InfiniteCod3/pico-pwm-generator/docs/mereni/seriova_linka_2026-10-13.txt

  3601 ms  Freq:    1000 Hz  Duty: 50 %  ON   (skutecne 1000.00 Hz)
  6678 ms  Freq:    1100 Hz  Duty: 50 %  ON   (skutecne 1100.00 Hz)
  7118 ms  Freq:    1200 Hz  Duty: 50 %  ON   (skutecne 1199.99 Hz)
  7632 ms  Freq:    1300 Hz  Duty: 50 %  ON   (skutecne 1299.99 Hz)
  8006 ms  Freq:    1400 Hz  Duty: 50 %  ON   (skutecne 1400.00 Hz)
  8068 ms  Freq:    1500 Hz  Duty: 50 %  ON   (skutecne 1500.00 Hz)
  8100 ms  Freq:    1600 Hz  Duty: 50 %  ON   (skutecne 1600.00 Hz)
  8131 ms  Freq:    1700 Hz  Duty: 50 %  ON   (skutecne 1700.01 Hz)
  8191 ms  Freq:    1800 Hz  Duty: 50 %  ON   (skutecne 1800.01 Hz)
  8223 ms  Freq:    1900 Hz  Duty: 50 %  ON   (skutecne 1899.98 Hz)
  8285 ms  Freq:    2000 Hz  Duty: 50 %  ON   (skutecne 2000.00 Hz)
  8317 ms  Freq:    2100 Hz  Duty: 50 %  ON   (skutecne 2099.99 Hz)
  8973 ms  Freq:    2200 Hz  Duty: 50 %  ON   (skutecne 2200.01 Hz)
  9379 ms  Freq:    2300 Hz  Duty: 50 %  ON   (skutecne 2299.99 Hz)
  9440 ms  Freq:    2400 Hz  Duty: 50 %  ON   (skutecne 2400.02 Hz)
  9471 ms  Freq:    2500 Hz  Duty: 50 %  ON   (skutecne 2500.00 Hz)
  9502 ms  Freq:    2600 Hz  Duty: 50 %  ON   (skutecne 2600.00 Hz)
  9564 ms  Freq:    2700 Hz  Duty: 50 %  ON   (skutecne 2700.02 Hz)
  9595 ms  Freq:    2800 Hz  Duty: 50 %  ON   (skutecne 2799.99 Hz)
  9626 ms  Freq:    2900 Hz  Duty: 50 %  ON   (skutecne 2900.03 Hz)
  9656 ms  Freq:    3000 Hz  Duty: 50 %  ON   (skutecne 2999.98 Hz)
  9719 ms  Freq:    3100 Hz  Duty: 50 %  ON   (skutecne 3099.97 Hz)
  9750 ms  Freq:    3200 Hz  Duty: 50 %  ON   (skutecne 3199.96 Hz)
  9781 ms  Freq:    3300 Hz  Duty: 50 %  ON   (skutecne 3299.98 Hz)
  9844 ms  Freq:    3400 Hz  Duty: 50 %  ON   (skutecne 3399.97 Hz)
  9876 ms  Freq:    3500 Hz  Duty: 50 %  ON   (skutecne 3500.03 Hz)
  9907 ms  Freq:    3600 Hz  Duty: 50 %  ON   (skutecne 3600.02 Hz)
  9969 ms  Freq:    3700 Hz  Duty: 50 %  ON   (skutecne 3699.98 Hz)
 10000 ms  Freq:    3800 Hz  Duty: 50 %  ON   (skutecne 3799.97 Hz)
