InfiniteCod3/pico-pwm-generator/docs/schema/generator.pdf

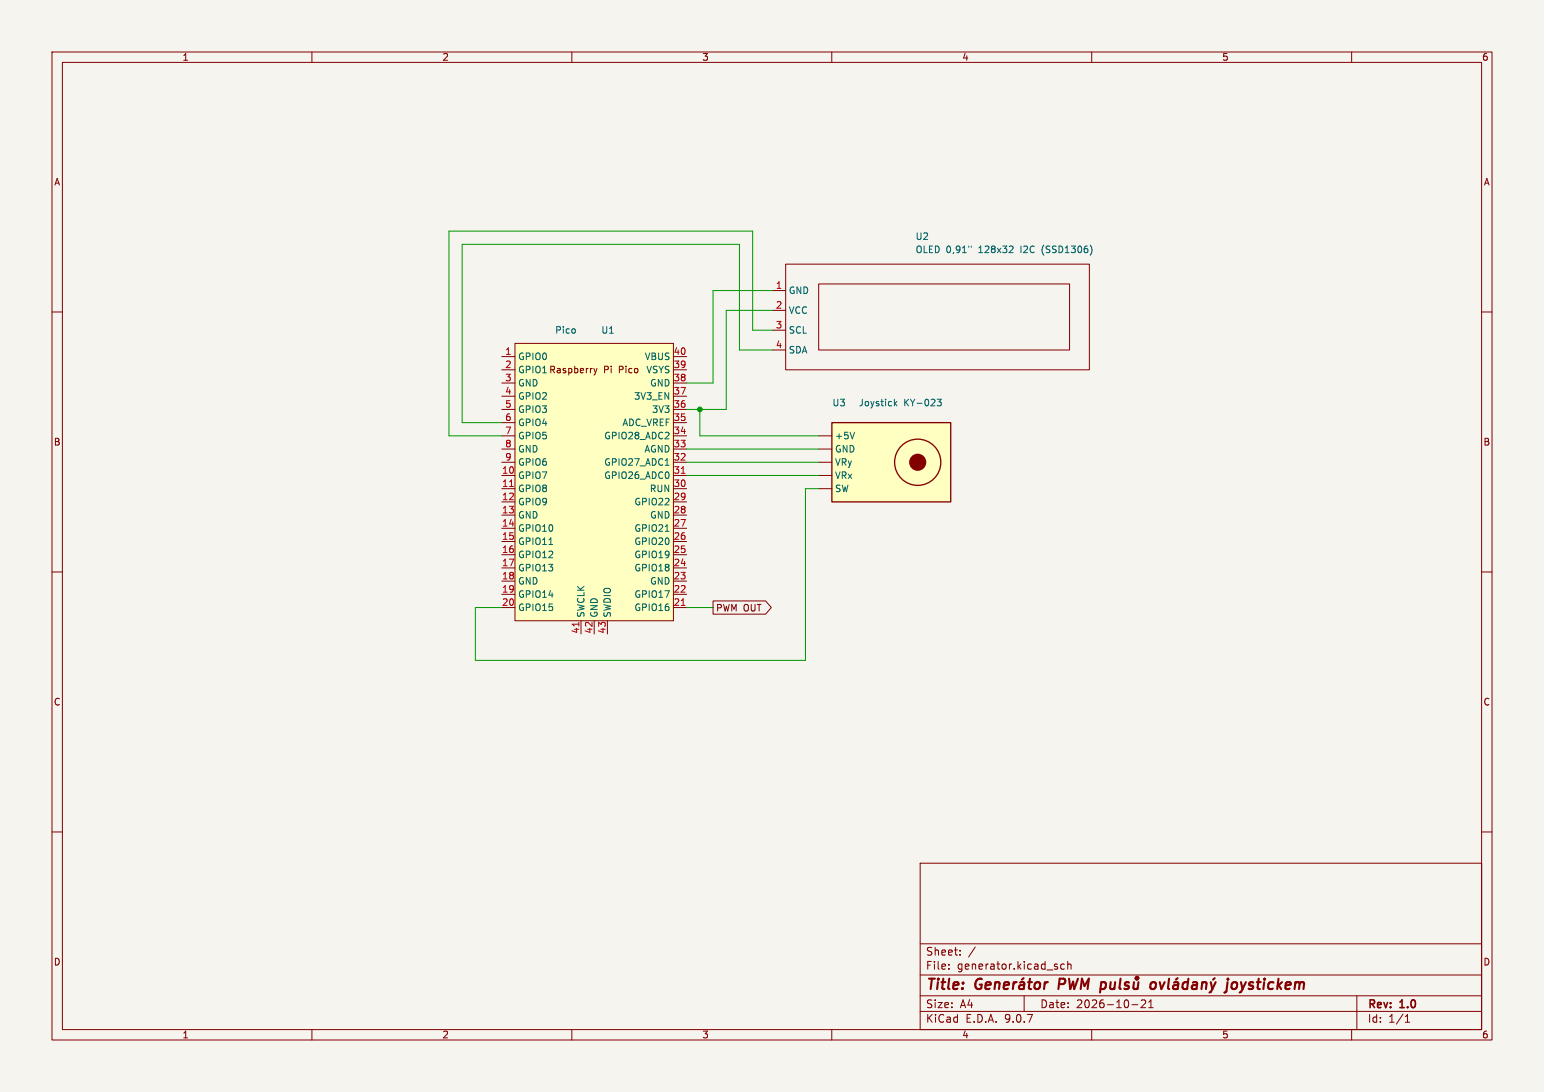
[picture p2: page 1]

File: generator.kicad_sch Sheet: /
Id: 1/1 Title: þÿGenerátor PWM þÿpulso þÿovládaný joystickem
