InfiniteCod3/pico-pwm-generator/docs/schema/generator.kicad_sch

## KiCad design docs/schema/generator.kicad_sch (2026-10-21)

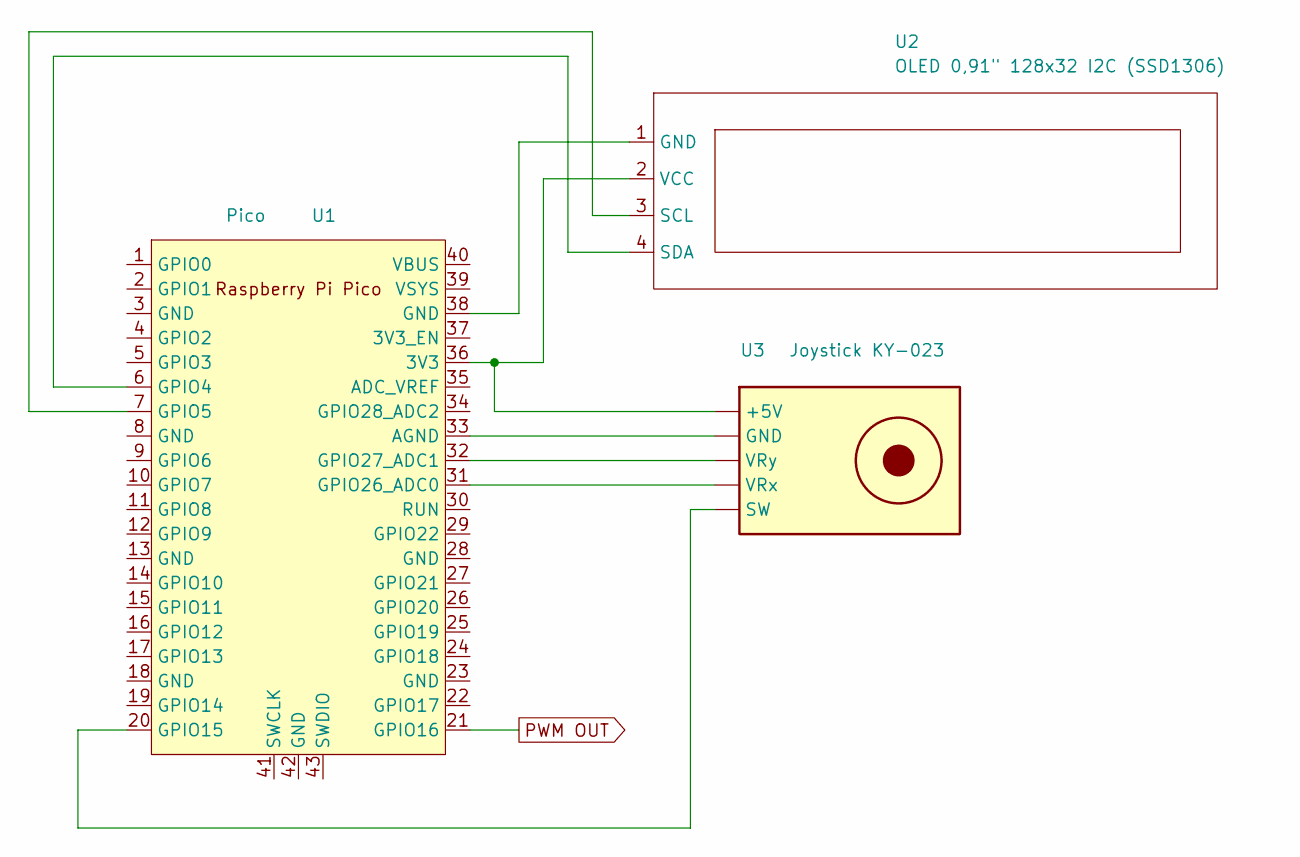
[picture p3: schematic generator.kicad_sch]

Parts:
U1: Pico
U2: OLED 0,91" 128x32 I2C (SSD1306)
U3: Joystick KY-023

Connections:
unnamed: U1.6 (GPIO4), U2.4 (SDA)
unnamed: U1.7 (GPIO5), U2.3 (SCL)
unnamed: U1.20 (GPIO15), U3.5 (SW)
unnamed: U1.31 (GPIO26_ADC0), U3.3 (VRx)
unnamed: U1.32 (GPIO27_ADC1), U3.4 (VRy)
unnamed: U1.33 (AGND), U3.1 (GND)
unnamed: U1.36 (3V3), U2.2 (VCC), U3.2 (+5V)
unnamed: U1.38 (GND), U2.1 (GND)
PWM OUT: U1.21 (GPIO16)
